sq6emm/eCzas-DCF-gps-stm32/doc/nucleo_architecture.pdf

# NUCLEO-H723ZG time receiver: e-CzasPL 225 kHz + DCF77 77.5 kHz + OCXO

Architecture of the current hardware and firmware - state of 29 September 2026, firmware commit e436259, repository sq6emm/eCzas-DCF-gps-stm32 (firmware/nucleo-h723, firmware/common). SQ6EMM / e-CzasPL receiver experiments.

## 1. Purpose and overview

A software-defined receiver for two long-wave time signals on one inexpensive development board. Two tuned ferrite rods feed two 16-bit ADCs that sample the band directly at 1 Msps; everything else is software: phase-locked mixers, coherent carrier trackers, the unchanged e-CzasPL firmware core for the time frames, an own DCF77 receiver with a per-minute time-code decoder, and a loop that steers a 10 MHz OCXO to the received carriers. The board runs continuously; a logger on the 'power' server records its text log and the two 2 kHz baseband streams for offline analysis.
| e-CzasPL | DCF77
transmitter | Solec Kujawski, 234 km, bearing 20° | Mainflingen, 580 km, bearing 261°
carrier / modulation | 225 kHz, phase modulation, 50 b/s, 3-s slots | 77.5 kHz, AM second marks + pseudo-random phase code
what the NUCLEO takes from it | time of day (clock), carrier frequency | carrier frequency (OCXO reference), second, minute time code
role | the receiver's clock (e-CzasPL core) | frequency reference for the OCXO; independent time check

## 2. Hardware

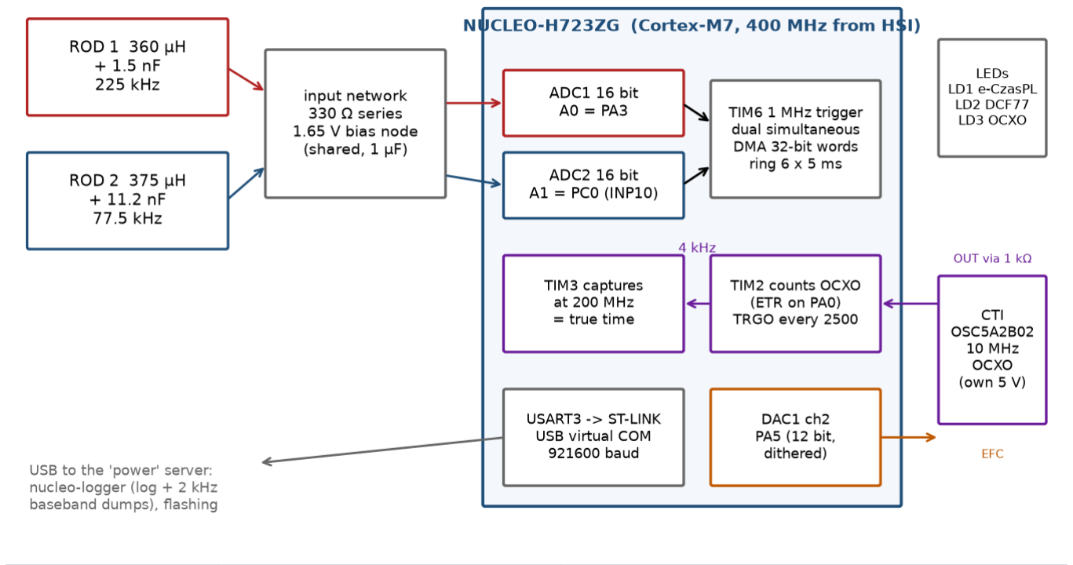
[picture p1: figure]

part | connection | notes
ROD 1 (225 kHz) | A0 = PA3 -> ADC1 | 360 µH ferrite rod, 1.5 nF tuning capacitor at the board, 330 Ω series
ROD 2 (77.5 kHz) | A1 = PC0 -> ADC2 (INP10) | 375 µH rod, 10 nF + 1.2 nF at the board, 330 Ω series
bias | shared 1.65 V node, 1 µF | both inputs biased to mid-scale (ADC mean ~32280 of 65535)
OCXO CTI OSC5A2B02 | OUT -> 1 kΩ -> PA0 (TIM2_ETR); EFC <-PA5 (DAC1 ch2); own 5 V | 10 MHz HCMOS; EFC slope measured +0.816 ppb per DAC code (1.07 ppm/V); locked near code 2252 = 1.815 V
MCU clock | HSI (16 MHz into the PLL) -> 400 MHz core, 200 MHz timers | the board has no crystal; HSI is ~+0.6 % off and wanders - the firmware measures it against the OCXO continuously
USB (ST-LINK) | USART3 virtual COM, 921600 baud | text log + binary baseband packets; also flashing (st-flash)

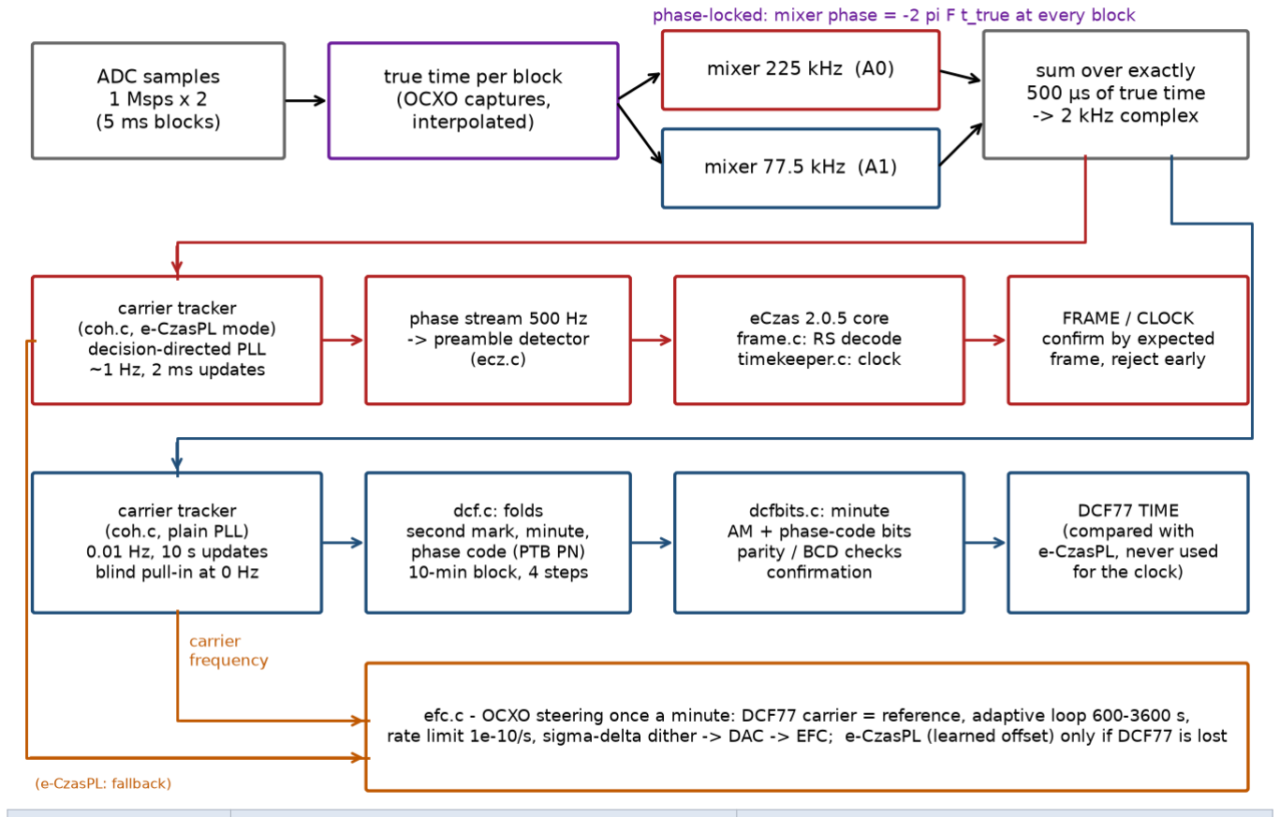
[picture p2: figure]

NUCLEO e-CzasPL + DCF77 receiver - architecture, 29.09.2026 - page 2

part | connection | notes
LEDs | LD1 green, LD2 yellow, LD3 red | LD1 e-CzasPL / LD2 DCF77: on = carrier locked, short blink = decode; LD3: on = OCXO locked, 1 Hz = calibrating/holdover

Input wiring: doc/nucleo_225_77kHz_input.pdf. OCXO wiring: doc/nucleo_ocxo_test_b.pdf.

## 3. Time base: sampling on true (OCXO) time

TIM6 triggers both ADCs together every 200 timer ticks (1 Msps, dual regular simultaneous mode); DMA writes 32-bit
words (ADC2 << 16 | ADC1) into a ring of 6 blocks of 5000 samples (30 ms). Because the CPU/timer clock (HSI) is
~6000 ppm off and wanders, sample count is not time. Therefore TIM2 counts the OCXO's 10 MHz on its external-clock input and produces a trigger every 2500 cycles (4 kHz); TIM3 timestamps each trigger in timer ticks. Interpolating between these captures gives the true time of every ADC sample. The previous build used the LSE watch crystal the same way (TIM16); -DOCXO_REF selects the OCXO.
Consequences: the mixers are phase-locked to true time (their phase is set to -2 pi F t_true at every 5 ms block), and the decimator sums exactly 500 µs of true time per output sample (fractional samples are split). So the HSI wander never appears as carrier phase noise, and every carrier measurement is a measurement against the OCXO.

## 4. Signal chain

stage | e-CzasPL | DCF77
mixer + decimation | 225 kHz, 2 kHz complex baseband | 77.5 kHz, 2 kHz complex baseband
carrier tracker (coh.c) | search: 2-s FFT; decision-directed 2nd-order PLL on the two data phase levels, ~1 Hz, updates every 2 ms | blind pull-in at 0 Hz (OCXO build; FFT search 128 s as fallback after 3 min); plain PLL 0.01 Hz, updates every 10 s; counts as locked only when its second marks are verified (spur rule: a line without marks is rejected after 60 min)
data | carrier-relative phase at 500 Hz -> ecz.c preamble detector -> eCzas 2.0.5 core (frame.c Reed-Solomon, CRC; timekeeper.c clock, sync, rejection of frames that disagree with the clock; confirmation of undecodable frames by the expected frame) | dcf.c: second mark (fold of the 100/200 ms reductions), minute marker (second 59), phase code (fold of the fixed-sign seconds correlated with the PTB sequence, anchored at pm_ref); dcfbits.c: per-minute AM + phase-code bits, parities, BCD ranges, confirmation by a second decode or by the expected frame
evaluation | per frame (every 3-s slot) | every 10 min (block, in four ~8 ms steps 0.1 s apart); early checks every 10 s until the first block: marks ~2 min, minute ~6 min, phase code ~7 min after boot

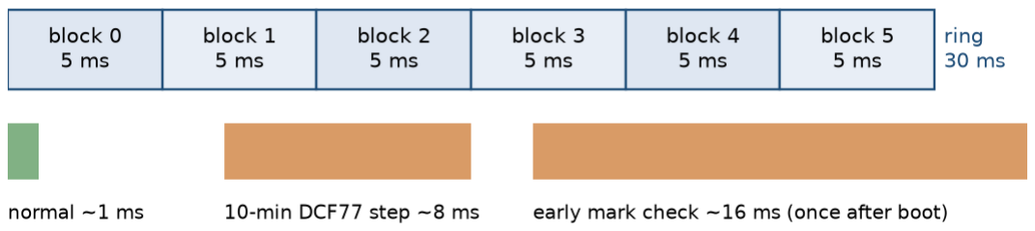
[picture p3: figure]

NUCLEO e-CzasPL + DCF77 receiver - architecture, 29.09.2026 - page 3

## 5. OCXO steering (efc.c)

Once a minute each carrier tracker reports its mean frequency against the OCXO time base (y = f / F; y > 0 means the OCXO runs slow). The steering loop turns that into a DAC code:
element | current setting
reference | DCF77 carrier (PTB-steered) only (EFC_WE_MAX 0); e-CzasPL steers only when DCF77 is lost, with its offset to DCF77 learned while DCF77 is clean (minute noise < 2 ppb)
start | straight into lock at code 2253 with the known slope 0.816 ppb/code; a station counts after 2 whole locked minutes
loop | 2nd-order PLL on the carrier phase (time error = integral of y), damping 0.7; time constant 600 s by day, lengthened automatically up to 3600 s when DCF77's minute noise grows (night)
actuator | DAC1 ch2 12 bit on PA5 -> EFC directly; changes rate-limited to 1e-10 / s (the 0.01 Hz DCF77 loop must not slip); first-order sigma-delta dither between neighbouring codes every 5 ms for sub-LSB resolution
calibration (fallback) | without a known slope: 3 min wait, half-way ramp, measured slope, sign checked; no response = FAILED
log line | OCXO once a minute: code and volts, state, source, e-CzasPL weight, offset (ppb), time error (ns), slope, loop time constant, learned e-CzasPL-DCF77 offset

Simulation (host/efcsim.c) before each change: by day ~18 ns time wander; a simulated night (3x DCF77 noise + ±300 ns sky-wave) 98 ns with the adaptive loop against 332 ns with a fixed 600 s loop; mixing both stations' frequencies was worse (585 ns) and is not used.

## 6. Processing budget

Processing per 5 ms block must on average stay far below 5 ms; a single slow block may take up to ~25 ms before the DMA overwrites unread samples (OVERRUN) - two heavy tasks in one sample took 32 ms on 28 Sep 21:38 and broke the DCF77 timing. Everything runs in the main loop, one 5 ms block at a time (no RTOS). Measured: CPU ~20 %, longest block 1-2 ms normally, 8-9 ms in the 10-min DCF77 steps. The early checks and the four block steps are placed in different samples so that two heavy tasks never meet. The host benches cannot see CPU time: the 'longest block' in the STATUS line is checked after every flash.

## 7. Outputs (text log on the USB serial port)

line | when | content
STATUS | 10 s | time (e-CzasPL clock), e-CzasPL carrier state and loop noise, frame counters, DCF77 carrier state, MCU clock offset, CPU %, longest block, ADC means/min/max, OVERRUN / PLBAD flags
FRAME / CLOCK | every e-CzasPL frame | correlation, SNR, RS corrections, decoded time; accepted / confirmed / REJECTED (early frames ~-2.4 s)
CARRIER | 1 min | both carriers: frequency vs OCXO (mHz), C/N0, loop noise, unwrapped phase, state
OCXO | 1 min | steering state (see section 5)
DCF77 TIME | 1 min | decoded DCF77 time, status (confirmed / by expected frame / unconfirmed / not decodable), comparison with e-CzasPL
DCF77 | 10 min | second mark, minute, phase-code timing with significance; DCF77 second vs e-CzasPL second, also at the transmitters
STATS | 1 h | guaranteed e-CzasPL frame at :03 (expected / heard / correct / confirmed), all time frames, early frames, DCF77 minutes, mean C/N0
TIMEMAP | 10 s | sample count -> e-CzasPL time (for offline alignment of the dumps)

NUCLEO e-CzasPL + DCF77 receiver - architecture, 29.09.2026 - page 4

line | when | content
binary packets | continuous | 2 kHz complex baseband of both mixers (A5 5C e-CzasPL, A5 5B DCF77), written to .c64 files by the logger

NUCLEO e-CzasPL + DCF77 receiver - architecture, 29.09.2026 - page 5

## 8. Host side (server 'power', all in Docker containers)

component | what it does
nucleo-logger | reads the USB serial port; text log /data/claude/nucleo-h723/log/rx.log, 10-min .c64 baseband files
nucleo-carrier-cmp | e-CzasPL vs DCF77 carrier comparison from the CARRIER lines (the board clock cancels): offset, Allan deviation, hourly report
nucleo-dcf-track | DCF77 timing from the dumps with e-CzasPL assistance (10-min phase-code lag, significance)
build / flash | arm-none-eabi-gcc in image eczas-arm:1, make CFLAGS_EXTRA='-DAUDIO_DUMP -DOCXO_REF'; st-flash over the ST-LINK
host tests | firmware/host: dcfsim, dcfminsim (the NUCLEO's DCF77 code on recordings; DCF_QUICK, DCF_BLIND, DCF_STAGED as the firmware), efcsim (steering loop vs a simulated OCXO); tools/dcfbench.py and dcfminbench.py: noise benches on KiwiSDR recordings with GPS truth - every DCF77 change must keep 0 wrong confirmed minutes
references | IC-7610 over LAN (e-CzasPL + DCF77, best reference receiver), KiwiSDR (Czech Republic, GPS-timed), Legnica bench (eCzas module)

## 9. Measured performance (28-29 Sep 2026)

| e-CzasPL | DCF77
C/N0 on the rods | 45 dB-Hz, day and night | 12-21 dB-Hz by day, 6-14 at night
carrier noise per minute (day) | 0.29 ppb | 0.71 ppb
decoding | 99.6 % of all time frames; 98.7 % of the guaranteed frame at :03 (00:30-09:30 UTC) | ~95 % of minutes confirmed by day; ~30 % in the worst night hours
second / timing | frames vs clock ±0.25 ms | phase code ±0.07 ms (30-min values)
e-CzasPL vs DCF77 carrier | -0.92e-9 over 9 h (Allan deviation 1.8e-10 at 3 h) | reference
OCXO locked to DCF77 | | 0.5-1 ppb rms per minute by day, time error ±0.25 µs by day, ±1 µs at night (fixed loop)
early e-CzasPL frames (-2.4 s) | detected and rejected, never used for the clock (events 31-50 all caught by the NUCLEO or the IC-7610)

## 10. Known limitations and next steps

- DCF77 on the small rod is weak at night (6-14 dB-Hz): minute decoding then relies on the expected frame; a better DCF77 antenna helps most.
- Absolute time: the e-CzasPL and DCF77 seconds differ by ~9 ms at the board; propagation (1.93 / 0.78 ms) is known, the rest (decoder and transmitter offsets) needs a GPS PPS reference (LEA-M8T) for a one-off calibration.
- The MCU runs on HSI and every sample is corrected in software; clocking the MCU from the OCXO (HSE bypass) would remove that layer.
- Third station TDF 162 kHz (Allouis): decoder proven offline on IC-7610 recordings; needs a 162 kHz rod (doc/three-station-design.md, doc/three_rods_layout.pdf) and a third mixer/tracker.
- Time output to other equipment (NMEA over USB to chrony, or NTP/PTP over the board's Ethernet) is not implemented yet.
