sq6emm/eCzas-DCF-gps-stm32/doc/antenna_head.pdf

~152

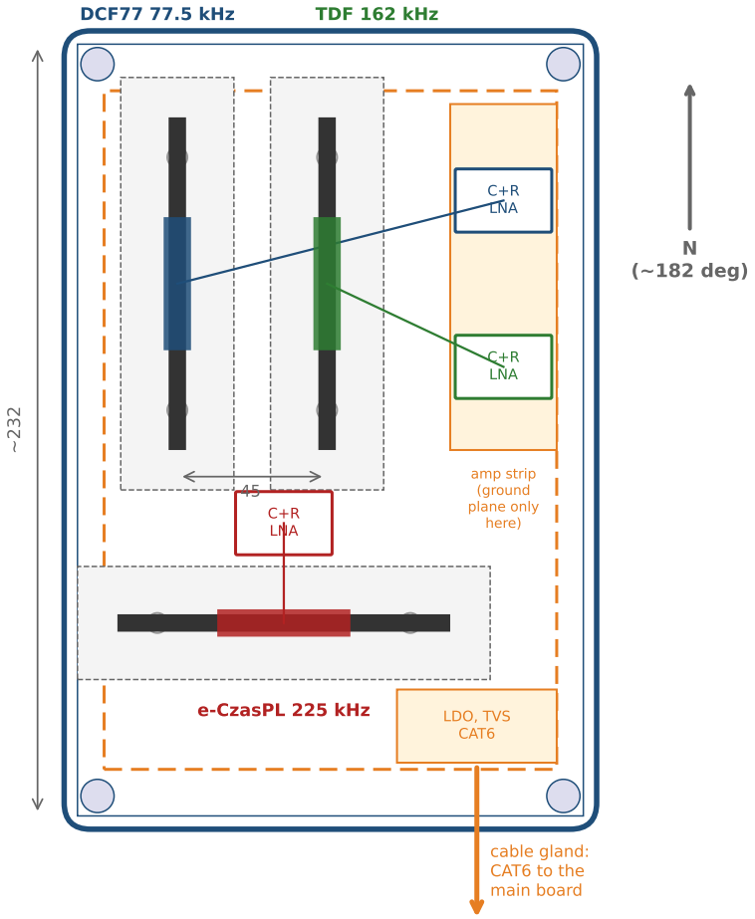
[picture p4: figure]
amp strip (ground plane only here); LDO, TVS CAT6; cable gland: CAT6 to the main board; C+R LNA; DCF77 77.5 kHz; TDF 162 kHz; e-CzasPL 225 kHz; N (~182 deg)

15-20

board

side view (rods DCF77 / TDF end-on), ~53 mm inside

N

E

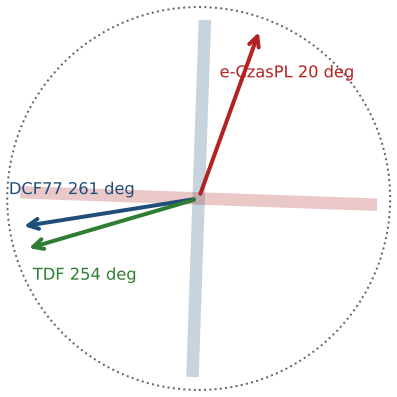
[picture p5: figure]
e-CzasPL 20 deg; DCF77 261 deg; TDF 254 deg

S

W

station bearings (arrows) and rod axes (bars)

# Antenna head - top view to scale (mm)

Hammond 1554VAL2GY (polycarbonate IP68, 240 x 160 x 60 mm outside, ~232 x 152 x 53 inside); rods 10 x 100 mm, L1 500 uH + 7-turn L2 (rod-antenna-spec.md); head board under the rods; GPS: separate antenna.

Rods at 90 deg: DCF77 + TDF parallel, e-CzasPL crosswise.

Box long side (DCF77 / TDF axis) to ~182 deg, i.e. ~north-south; each rod is then off its ideal (broadside) direction by

DCF77 11, TDF 18, e-CzasPL 18 deg: at most -0.45 dB.
Board under the rods, rods on plastic standoffs 15-20 mm above it;

no copper under the rods except narrow traces, ground plane only

in the amp strip and the supply corner, no closed copper loops.

Tank (L1 + C + R, Q ~ 30) at each rod; tune in place with all

three rods mounted and the lid on (SPECTRUM hump).
Rod spacing 45 mm (rods on different frequencies couple weakly):

verify with the prototype (resonance with / without neighbours).

GPS: a separate active antenna (sky view) on its own coax.

150 mm rods: the same layout in a 1554X2GY (300 x 200 x 90).

SQ6EMM / e-CzasPL receiver experiments, 30.09.2026 - a proposal, verify with the prototype (frontend-architecture.md, 6); box inside dimensions from a distributor listing - check the Hammond drawing

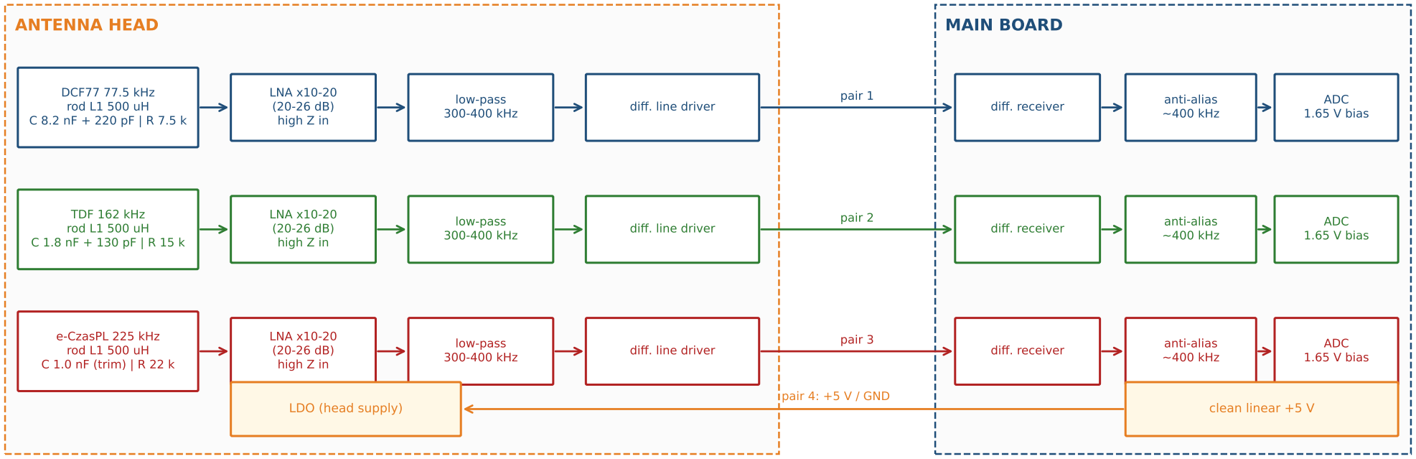
[picture p6: figure]
ANTENNA HEAD; MAIN BOARD; DCF77 77.5 kHz rod L1 500 uH C 8.2 nF + 220 pF | R 7.5 k; LNA x10-20 (20-26 dB) high Z in; low-pass; 300-400 kHz; diff. line driver; pair 1; diff. receiver; anti-alias; ~400 kHz; ADC 1.65 V bias; TDF 162 kHz rod L1 500 uH C 1.8 nF + 130 pF | R 15 k; pair 2; e-CzasPL 225 kHz rod L1 500 uH C 1.0 nF (trim) | R 22 k; pair 3; LDO (head supply); clean linear +5 V; pair 4: +5 V / GND

pair | variant A (three lines) | variant B (one summed line)
1 | DCF77 | three stations summed
2 | TDF | spare
3 | e-CzasPL | spare
4 | +5 V / GND | +5 V / GND

CAT5e / CAT6, differential twisted pairs

# Antenna head - signal chain per station, cable and main board

Values: C0G capacitors at the rod (C = 1/((2 pi f)^2 L), recompute

from each rod's measured L), R across L1 for Q ~ 30.

Why the amplifier: the rod's antenna noise must stay well above the

ADC noise floor (measured ~15 dB margin at the tank; the 7-turn

link alone would cost ~18 dB).

LNA: <= 10 nV/sqrt(Hz), GBW >= 50 MHz for x20 at 225 kHz (or 2 stages).

Variant B: one ADC input for all three stations (STM32H730),

separated by the firmware's digital mixers.

ESD/TVS at both cable ends; common-mode rejection by the pairs.

GPS: separate active antenna, own coax to the main board.

SQ6EMM / e-CzasPL receiver experiments, 30.09.2026 - see frontend-architecture.md
