sq6emm/eCzas-DCF-gps-stm32/doc/nucleo_225kHz_input.pdf

# Frame antenna to NUCLEO-H723ZG A0 - simplest input

For the e-CzasPL 225 kHz probe firmware (ADC on A0 = PA3, 1 Msps)

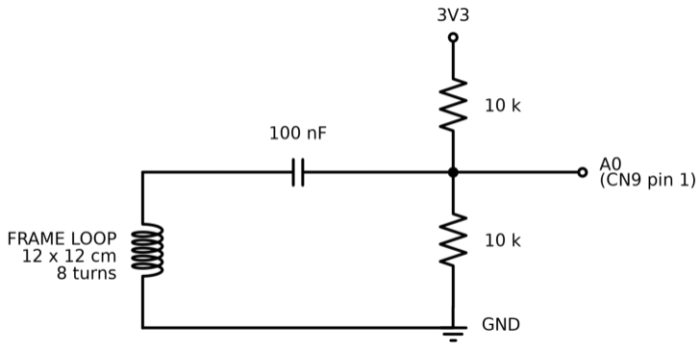
[picture p11: figure]

## Parts

1 x capacitor 100 nF (any ceramic)

2 x resistor 10 kOhm

## Connections

Loop end 1 -> 100 nF -> A0 (CN9 pin 1)

A0 -> 10 k -> 3V3 | and | A0 -> 10 k -> GND

Loop end 2 -> GND

3V3 and GND: the pins with these labels on CN8, next to CN9.

## Why

The two 10 k resistors hold A0 at 1.65 V, the middle of the ADC range.
The 100 nF passes the 225 kHz signal but keeps the loop (a short at DC) off that bias.

## What the probe should show

ADC mean about 32768 and no 'min 0'. A received carrier: SNR clearly above 0 dB and a steady offset of a few Hz. Turn the loop for the highest SNR.

Later, for about 30x more signal: add 27 nF (C0G) directly across the loop ends.

SQ6EMM / e-CzasPL receiver experiments, 27.09.2026
