sq6emm/eCzas-DCF-gps-stm32/doc/antenna_head.png

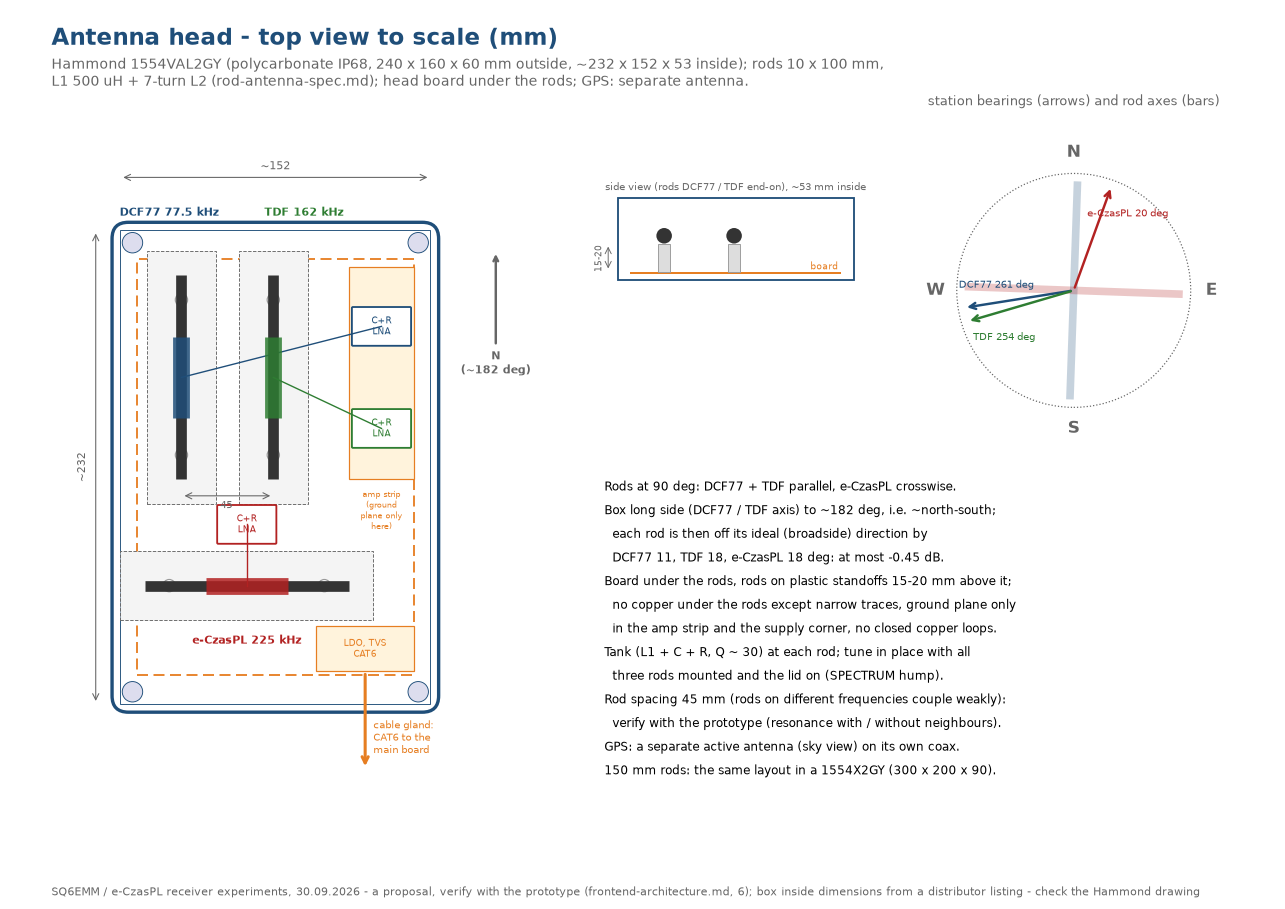
doc/antenna_head.png
