sq6emm/eCzas-DCF-gps-stm32/doc/nucleo_gps_pps.png

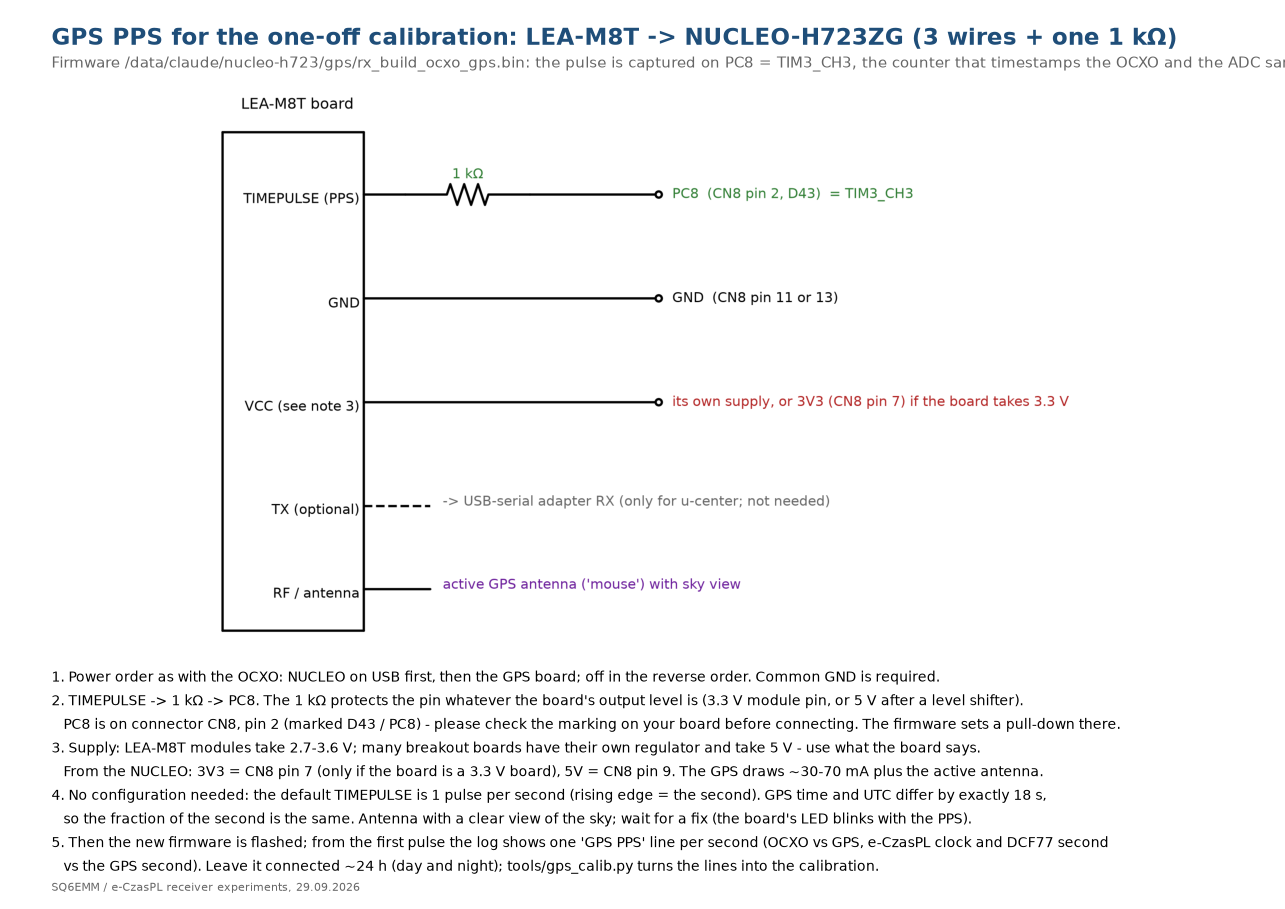
doc/nucleo_gps_pps.png
