sq6emm/eCzas-DCF-gps-stm32/doc/three_rods_layout.png

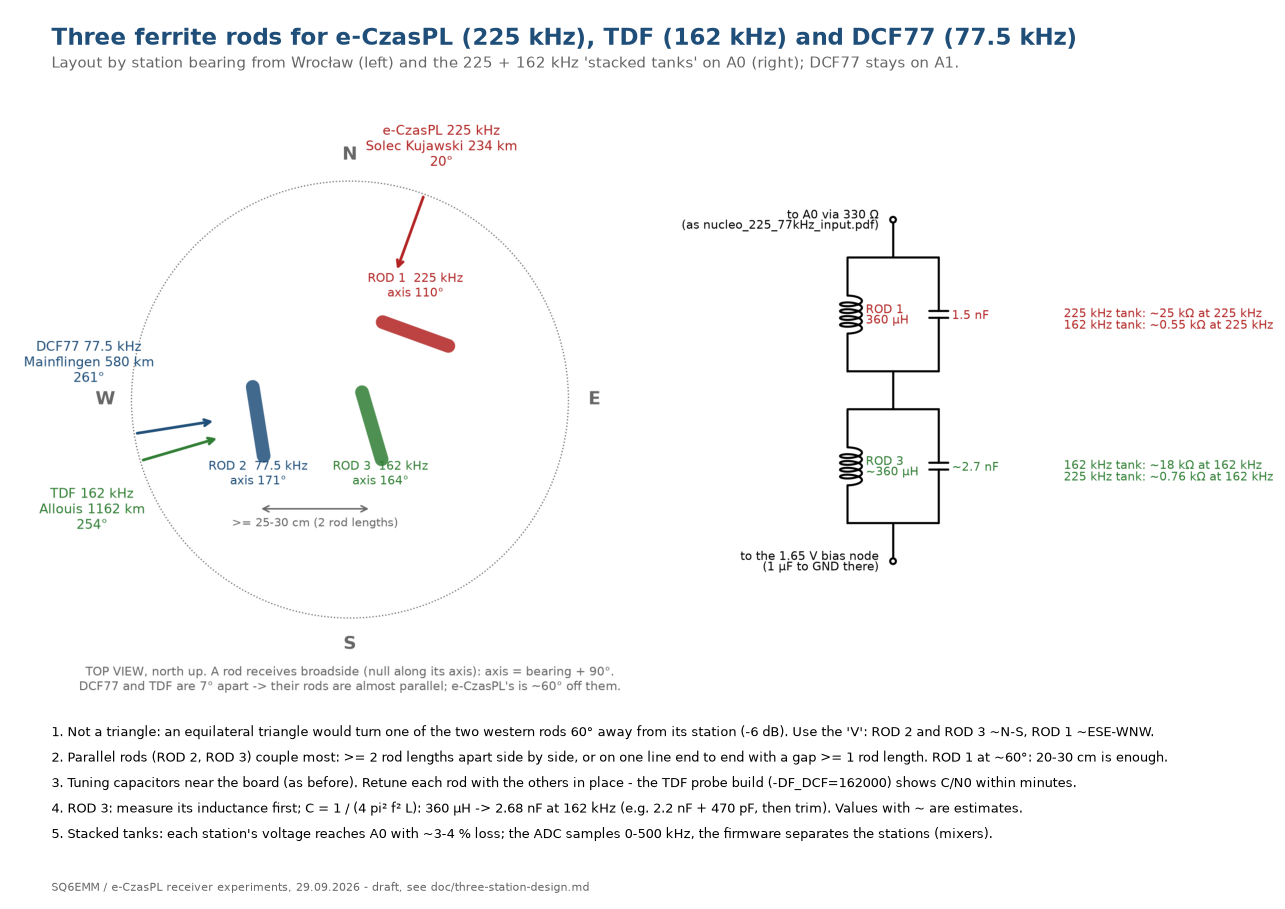
doc/three_rods_layout.png
