sq6emm/eCzas-DCF-gps-stm32/doc/nucleo_ocxo_test.png

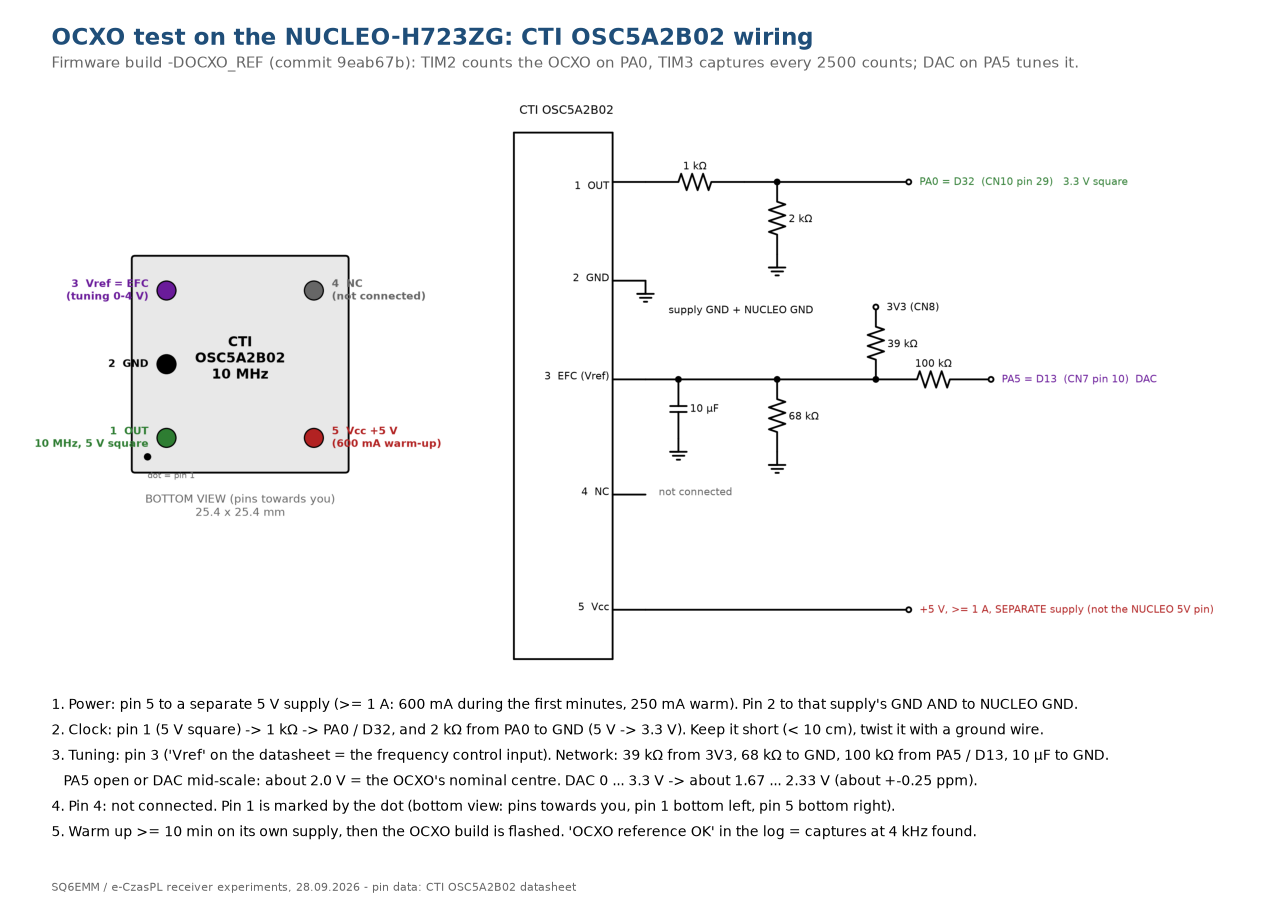
doc/nucleo_ocxo_test.png
