sq6emm/eCzas-DCF-gps-stm32/(commit log)

2026-09-27 NUCLEO-H723ZG port: direct-sampling receiver with the unchanged eCzas core
    ADC 1 Msps on A0, mixer phase-locked to the LSE crystal (HSI clock), 10 kHz
    stream into dsp.c/frame.c/timekeeper.c. Includes the serial/audio logger and
    comparison tools. First run decodes 85 % of time frames next to the IC-705.
2026-09-27 NUCLEO: complex +-400 Hz image filter before the real part (84.5 % -> 92.7 % of time frames)
2026-09-27 Move the STM32 work out of the eCzas repo: firmware/, tools/, doc/, PLAN.md
    History of Firmware/nucleo-h723 kept (subtree split). The eCzas core comes from the
    eczas submodule. Build is byte-identical to the running firmware.
2026-09-27 Coherent receiver core: carrier tracker (coh.c) + eCzas detector (ecz.c) + host test vs the old core
    Same tracker code for eCzas and DCF77 (independent instances). eCzas: 20-32 % more time frames
    than the SI4735-style core in weak signal, equal otherwise, 0 wrong times in all host tests.
2026-09-27 M3 firmware: coherent receivers for e-CzasPL and DCF77, independent of each other
    No more SI4735 imitation: phase-locked mixers -> 2 kHz complex -> own carrier tracker per
    station (coh.c) -> eCzas frames (ecz.c + frame.c/timekeeper.c) and DCF77 timing (dcf.c).
    CARRIER lines with C/N0, frequency and phase per station, DCF77 report every 10 min, LD2 =
    DCF77 lock. Both streams dumped as 2 kHz complex (logger: ecz_*/dcf_*.c64).
2026-09-27 M3: DCF77 counts as locked only with confirmed second marks (LD2, STATUS, CARRIER ppb)
    A local spur can be tracked but has no 1-s amplitude pattern; the ppb comparison printed
    +21000 ppb on the -1.73 Hz spur. After a spur rejection the old mark result is cleared.
2026-09-27 M3: fix sample skips every 10 min (DCF77 evaluation 60+ ms -> 16 ms), 60 ms DMA ring, line buffers
    The 10-min dcf_block used % in its inner loops and outran the 40 ms DMA ring: ~27 ms of
    samples were skipped each time, shifting all later frame timing (eCzas clock corrections,
    broken DCF77 tracker blocks). Now: doubled fold array without modulo (16 ms measured),
    ring 60 ms, STATUS shows the longest block; STATUS/put_line buffers no longer truncate.
    [main.c]
2026-09-28 DCF77: follow the drift of the DCF77 second through the LSE time scale (fold shifted by -f/77500)
    The LSE crystal runs ~1.5 ppm fast, so the DCF77 second walks ~5.6 ms/h through the LSE
    second; the running fold (~1 h) was not following it and the 'vs e-CzasPL' offset drifted
    -7 -> -22 ms in two hours. The shift uses only the DCF77 carrier's own frequency. Offline on
    tonight's data: -10.1..-10.7 ms steady over 2 h.
    [main.c]
2026-09-28 DCF77 spur check: count through re-searches that find the same line (+-0.15 Hz)
    After the 03:39 reflash the -1.8 Hz spur was lost and found again every ~20 min at slightly
    different frequencies; the 60-min count restarted each time and the spur was never rejected.
2026-09-28 DCF77 spur rule: never reject a line that has shown second marks
    At 07:18 on 28 Sep the real DCF77 carrier (-0.1 Hz) was rejected after four
    good mark blocks (7-10 sigma) and one weak one: the block count was never
    reset by a good mark. Now a line with a >=6 sigma mark is proven and kept;
    only lines without any mark in their first 60 min are rejected. Replay of
    the 05:01-07:21 baseband: old code rejects -0.121 Hz, new code keeps it; the
    -1.77 Hz spur is still rejected.
    [main.c]
2026-09-28 tools/icomlan: Icom LAN/WLAN client recording the 12 kHz IF output
    Receive-only client for the Icom network protocol (after kappanhang and
    wfview): login, CI-V and audio streams, retransmits, 10-min WAV files.
    IF -> 8 kHz USB-audio conversion (one-sided), a watcher feeding the eCzas
    reference pipeline, and the USB AF vs WLAN IF comparison.
    IC-705 over WLAN, 28 Sep 09:17-09:27 UTC: USB AF 15 frames decoded, WLAN
    IF 18; 0 of 60001 packets lost. Prepared for the IC-7610 (MAIN 225 kHz /
    SUB 77.5 kHz as a stereo stream).
2026-09-28 tools/kiwi: KiwiSDR GPS-timed references for e-CzasPL and DCF77
    kiwi_ref.py records 225 kHz (or 77.5 kHz) IQ from public KiwiSDRs, places
    the 512-sample blocks by their GPS timestamps into 10-min UTC slots and
    feeds the e-CzasPL reference pipeline (frames, early frames) or dcfsim
    (the NUCLEO's coh.c + dcf.c) with a GPS time base. cmp_site.py compares the
    carrier quality at a Kiwi with our own recording in the same seconds; on
    28 Sep it showed the disturbance from ~09:15 UTC is local to our site.
2026-09-28 DCF77 tuning bench on GPS-timed Kiwi data
    tools/dcfbench.py: clean KiwiSDR DCF77 (tools/kiwi, GPS time base) made as
    weak as the NUCLEO's reception (calibrated complex noise, crystal error
    -1.8 ppm with its carrier offset), run through dcfsim variants and scored
    per 10-min block against the truth from the clean signal: second mark,
    minute (must be second 59), phase-code time; wrong results counted.
    dcf.h / dcfsim.c: DCF_KEEP, DCF_MARK_MIN, DCF_MIN_MIN and the carrier
    tracker config can be overridden with -D (defaults unchanged, firmware
    identical). tools/Dockerfile.bench: gcc + numpy image.
2026-09-28 icomlan: keep the file time right when the radio drops audio
    Over WLAN the IC-705 sometimes drops audio without a gap in the packet
    sequence (28 Sep 11:10-11:30: 47444 instead of 48000 samples/s), so later
    frames looked up to 7 s early. The recorder now compares each packet's
    arrival time with the samples written (against the lowest delay of the
    last 30 s) and inserts silence when it falls behind by > 100 ms. SIGTERM
    (docker stop) now closes the current file.
2026-09-28 dcfbench: fix the sign of the simulated crystal's carrier offset
    A fast LSE (e < 0) stretches the time axis and puts DCF77 below 0 Hz
    (the NUCLEO sees -0.14 Hz). The bench had +0.14 Hz, so dcf.c's drift
    compensation doubled the drift instead of removing it (wrong marks even
    at +20 dB-Hz). Now +20 dB-Hz: marks 100 % right, 0 wrong.
2026-09-28 doc: two-rod input (225 kHz on A0, 77.5 kHz on A1) with one shared bias node
    Both tuned ferrite rods (360 uH) sit between their ADC pin and a common
    1.65 V bias node that is decoupled to ground (1 uF): no coupling
    capacitors, one divider for both channels, and the tuned circuits are no
    longer loaded by the 10k/10k divider (Q about 8 -> about 50, roughly 15 dB
    more signal). C1 = 1.2 nF + 180 pF (225.8 kHz), C2 = 10 nF + 1.8 nF
    (77.2 kHz). Placement: rods crossed (225 kHz axis E-W, DCF77 axis N-S).
2026-09-28 doc: two-rod input PDF layout (title and all notes fit on the page)
2026-09-28 doc: second rod measured 375 uH -> C2 = 10 nF + 1.2 nF (77.7 kHz)
2026-09-28 doc: two-rod input redrawn with the tuning capacitors at the board end
    The rods are alone at the antenna end; each twisted pair ends at the board
    where C1 / C2 sit across it at the pins, with R1, R2, C3. All parts that
    need trimming are in one place; the cable capacitance (~50 pF/m) adds to
    C1 / C2 (with 1 m: C1 = 1.2 nF + 150 pF).
2026-09-28 kiwi_ref dcf: start the hourly dcfsim window at the first recorded slot
    A zero-filled lead-in (window 06:00-12:00, data from 10:40) let the carrier
    tracker hold a phantom line for 6 blocks; the spur rule then rejected 0 Hz,
    where DCF77 is, and the run ended searching. From the first slot: mark
    3.5 ms 91 sigma, minute 95 sigma, phase code 96 sigma, DCF77 second
    +4.78 ms after UTC (GPS) at Luisenfelde.
2026-09-28 doc: two-rod input with pin protection (330 Ohm series, optional clamp diodes)
    C1 / C2 -> R3 / R4 330 Ohm -> A0 / A1 limits the current into the pins
    (STM32 max 5 mA); a BAT54S / BAV99 dual diode per pin to 3V3 and GND is
    drawn as optional, to add later. The tuning capacitors stay on the rod
    side, so the tuning does not change.
2026-09-28 icomlan: timing guard rewritten - the first one inserted 10,236 s of silence
    28 Sep 12:31-12:41 the guard filled a 1 GB file with 10,236 s of silence
    (866,616 samples/s): after each insertion it shifted all stored reference
    lags as well, so the deficit never went away. Now: per second the smallest
    arrival lag, reference = median of the last 30; a deficit > 0.1 s in two
    consecutive seconds is filled (max 1 s at a time) and the reference is left
    alone; > 5 s is taken as a restart (re-anchor, no silence); stale arrival
    times are purged (16-bit sequence wraps every ~11 min).
    Offline simulation, 30 min of 10 ms packets with jitter and a 2 s WLAN
    stall: radio drop of 0.5 s without a sequence gap -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
2026-09-28 NUCLEO: DCF77 from its own rod on A1 (ADC2), e-CzasPL stays on A0
    ADC1 (A0 = PA3) and ADC2 (A1 = PC0, INP10) in dual regular simultaneous
    mode on the same TIM6 trigger; the DMA fetches one 32-bit word per sample
    pair from the ADC12 common data register (ADC2 << 16 | ADC1). The DCF77
    mixer takes the A1 half (-DDCF_ON_A0 for the old behaviour); the e-CzasPL
    path sees exactly the same samples as before. The ring is now 6 blocks of
    32-bit words (30 ms, 120 KB as before). STATUS shows mean / min / max of
    both ADCs.
    On the board 28 Sep 13:26 (new input doc/nucleo_225_77kHz_input.pdf): the
    min/max readout found the shared bias node at ~0 V (pins at 13 mV, A1
    clipping); after the user's fix both me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
    [main.c]
2026-09-28 dcf.c: phase-code fold on its own anchor, used only above 8 sigma
    The phase-code fold was indexed from the second mark, which is quantised
    to 0.5 ms and steps with the drift correction: each step realigned the
    fold and smeared it by 0.5-1 ms (timing jumping +4.8 / +5.7 / +4.9 ms from
    block to block). Now the fold has its own anchor (pm_ref), set from the
    mark when the minute is found and then moved only by the drift correction;
    the lag is still reported relative to the mark. Phase-code times are used
    (dcfsim, NUCLEO DCF77 vs e-CzasPL) only above DCF_PM_MIN = 8 sigma: the
    remaining 0.6-0.8 ms errors all had 5.4-6.5 sigma.
    Bench (tools/dcfbench.py, Kiwi Luisenfelde 10:40-13:40, GPS truth, 3 n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
    [main.c]
2026-09-28 DCF77 time code decoded every minute (dcfbits.c), next to the timing (dcf.c)
    Every second: AM (110-190 ms reduced or not) and PM (512 known chips from
    200 ms, inverted for 1; seconds 15-58, about 4x the energy of AM) are
    turned into log-likelihood ratios from the measured sample noise and
    added. The PM polarity and amplitude come from the known PM seconds 0-9
    (inverted) and 10-14 (not inverted). A minute is checked (bit 0 = 0,
    bit 20 = 1, P1 P2 P3, one of CEST/CET, BCD ranges); a failing parity group
    may flip its least reliable bit once. First confirmation: two standalone
    decodes that agree with the minutes elapsed. After that each minute is
    confirmed if it decodes to the expected time, or i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
    [main.c]
2026-09-28 Board design draft v0.1 and the e-CzasPL vs DCF77 carrier comparison logger
    doc/board-design.md: one board with the two rod inputs (direct sampling
    as on the NUCLEO), a u-blox timing GPS as the truth reference (PPS on a
    timer capture) and a 10 MHz OCXO that clocks everything and is steered
    through a 16-bit EFC DAC; outputs 10 MHz x2, 1PPS, USB, Ethernet. Open
    questions for the user listed.
    tools/carrier_cmp.py (container nucleo-carrier-cmp): from the NUCLEO's
    CARRIER lines, delta = phase_e/225000 - phase_d/77500 (the board clock
    cancels), segments at unlocks / restarts / slips, hourly report with the
    relative frequency offset and the Allan deviation, day / night.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
2026-09-28 board design v0.2: OCXO = CTI OSC5A2B02 (5 V, many units) - specs and consequences
    HCMOS 5 V output -> 74LVC1G17 to the 3.3 V HSE input and separate buffers
    for the 10 MHz outputs; own low-noise 5 V for 0.6 A warm-up; EFC 0-4 V at
    ~0.75 ppm/V: 16-bit DAC + REF5040 through a divider to ~1-3 V (~2.3e-11
    per LSB, dithered) or an 18-bit DAC. Enough for a loop at 1000-10000 s.
2026-09-28 board design v0.3: decisions - LEA-M8T, Ethernet, 12 V in, KiCad, JLCPCB assembly
2026-09-28 board design v0.4: GPS not on the board, header only (calibration station)
2026-09-28 NUCLEO: optional OCXO time base (-DOCXO_REF) instead of the LSE crystal
    The external 10 MHz OCXO (CTI OSC5A2B02, 5 V HCMOS through a 1k/2k divider
    to PA0 = D32) is counted by TIM2 (ETR, external clock mode 2); every 2500
    counts (4 kHz) TIM2's TRGO is captured by TIM3 (IC1 on TRC), which runs on
    the same timer clock as the ADC trigger TIM6 - the same mechanism as TIM16
    capturing LSE/8, so the phase-locked mixers and all timing follow the OCXO.
    The internal trigger (ITR1 expected) is verified at start: the one giving
    4 kHz captures is kept, otherwise 'OCXO reference NOT running'. EFC: DAC1
    channel 2 on PA5 (D13) at mid-scale (EFC_INIT) through 39k/68k/100k to the
    OCXO's control pin (~1.67-2.33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
2026-09-28 doc: OCXO test wiring (CTI OSC5A2B02 bottom-view pinout + NUCLEO connections)
2026-09-28 doc: OCXO test variant B - 4 wires + one 1 kOhm (EFC straight to the DAC on PA5)
2026-09-28 NUCLEO OCXO: close the loop - EFC steered from DCF77 (e-CzasPL fallback)
    common/efc.c: waits for 3 minutes on one source, calibrates the EFC slope with a
    half-way step (sign and size measured, dead EFC detected), then a second-order PLL
    on the carrier phase (tau 600 s, damping 0.7). EFC changes are rate-limited to
    1e-10/s so the ~0.01 Hz DCF77 carrier loop never slips, and dithered (first-order
    sigma-delta per 5 ms block) for sub-LSB resolution. Holdover when no carrier is locked.
    One OCXO line per minute. host/efcsim.c tests it against a simulated OCXO
    (slope 0.3..1.5 and reversed, offsets -300..+162 ppb, dropouts, dead EFC).
    STATUS names the reference (LSE/OCXO).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
    [main.c]
2026-09-28 NUCLEO LEDs: LD1 e-CzasPL / LD2 DCF77 on while locked, blink at each decode; LD3 OCXO loop state
    LD1/LD2 are inverted for 300 ms at every correctly decoded frame / DCF77 minute; LD3 is on when
    the OCXO loop is locked, blinks at 1 Hz while calibrating / moving / in holdover, off otherwise.
    Documented in the README (with the new per-minute OCXO line). EFC_INIT 2310 for this OCXO
    (162 ppb slow at 2048), so a restart does not start from mid-scale.
    [main.c]
2026-09-28 icomlan: IC-7610 over Ethernet - mirrored IF (--invert), stereo MAIN/SUB, DCF77 SUB analysis, K9AY scan
    The IC-7610 LAN IF is mirrored (RF f -> 12 kHz - (f - dial)); dials MAIN 226.000 / SUB 78.500 kHz put
    e-CzasPL and DCF77 at 13000 Hz. ifconv/if2af_watch/if2audio: --invert, --ch. dcf7610.py runs the
    NUCLEO's dcfsim/dcfminsim over the SUB channel hourly. K9AY and preamp/ATT scan results in the README.
2026-09-28 NUCLEO OCXO: steer from both carriers - DCF77 for accuracy, e-CzasPL (offset removed) for low noise
    efc_minute2(): e-CzasPL's offset against DCF77 is learned while both are locked (10 min, then
    3 h average) and removed; the two are weighted by their measured minute-to-minute noise (inverse
    variance); > 10 ppb disagreement = DCF77 alone that minute; one lost = the other alone. The OCXO
    line reports the weight and the learned e-CzasPL-DCF77 offset (a continuous carrier comparison).
    Known slope (0.816 ppb/code, EFC_SLOPE) starts straight in LOCK at EFC_INIT 2253 - no calibration.
    efcsim (EFC2, NIGHT, KNOWN, dropout 3): offset learned to 0.01 ppb, no frequency bias, DCF77
    dropouts 94 ns time wan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
    [main.c]
2026-09-28 DCF77: faster lock - early second-mark check and blind pull-in at 0 Hz on the OCXO build
    dcf_quick_mark(): until the first marks, the current block's fold is checked every 10 s once
    >= 60 s are tracked (10 sigma), instead of waiting for the first 10-min block. The mark search
    moved into mark_find() (shared with dcf_block; output byte-identical to before on all 11 bench
    inputs with the new options off). coh_pull_at()/coh_search(): the OCXO build pulls DCF77 in at
    0 Hz right away (the OCXO is steered to the carriers), normal search if no marks within 3 min.
    Host sims: DCF_QUICK=1, DCF_BLIND=hz.
    Bench (Kiwi Luisenfelde, 13/15/17 dB-Hz x 3 seeds): marks at 120 s (blind) / 240 s instead of
    600 s;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
2026-09-28 DCF77: minute marker and phase code also checked early - first confirmed minute ~12-15 min after boot
    minute_eval()/pm_eval() split out of dcf_block (output byte-identical with the options off);
    dcf_quick_minute() (8 sigma, while no minute) and dcf_quick_pm() (until the first 10-min block)
    evaluate the running sums every 10 s without decaying them. Host sims: DCF_QUICK=2, DCF_QMIN.
    Minute bench (13/15/17 dB-Hz x 3 seeds, blind pull-in): first confirmed minute 41/34/33 min
    (original) -> 27/15/12 min, confirmed minutes 66/77/79 % -> 73/86/89 %, WRONG confirmed 0;
    early minute always the right one (8 and 6 sigma tested; 8 kept). Timing bench: 0 wrong,
    phase code 94-100 % of blocks, rms 168-176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
    [main.c]
2026-09-28 e-CzasPL reference processor: no frame lost at the 10-min file joins
    Each file gets the last 30 s of the previous file in front when the two join exactly (within
    50 ms); frames and slots are counted by the file in which the slot ends, so nothing is doubled.
    Replay of the IC-7610 20:00-21:30 files, old vs new: every join now yields its 1-2 missing slots,
    time frames decoded 308 -> 310 (20 h) and 158 -> 160 (21 h), no slot lost or doubled. Shared by
    eczas-ic7610-proc, kiwi-ref-proc and eczas-ic705-proc (restarted 21:4x UTC).
2026-09-28 NUCLEO: early DCF77 checks in their own samples - they caused an OVERRUN
    21:38:43: the 10-min DCF77 block (~24 ms) and the early phase-code check (~8 ms) ran in the same
    sample: 32 ms against a 30 ms sample ring -> OVERRUN, samples skipped, the DCF77 second moved
    against the phase-code anchor and every minute failed afterwards (AM=PM ~50 %). The early mark /
    minute / phase-code checks now run at 0 / 3 / 6.5 s of each 10 s and never in a block's sample.
    Host sims use the same samples; minute bench unchanged (12.0 / 14.3 / 25.3 min, WRONG confirmed 0).
    The benches cannot see CPU time: the board's longest block is the check for this.
    [main.c]
2026-09-28 TDF (ALS162, 162 kHz) offline decoder on IC-7610 recordings
    Third LF station: 48 dB-Hz on the K9AY. Phase modulation +-0.8 rad, bit 0 = one ~100 ms cycle,
    bit 1 = two, DCF77 time-code layout (next minute, French legal time). tdf_decode3: complex LS
    fit per second with learned shapes (no phase unwrapping), matched-filter second alignment,
    minute marker folded over all minutes, parity repair, BCD checks, neighbour confirmation.
    Noise bench: confirmed 9/8/8/4/0 of 9 minutes at 49/25/22/20/18 dB-Hz, WRONG confirmed 0.
2026-09-29 NUCLEO: F_DCF overridable (TDF probe); TDF decoder: impossible dates count as failed
    Probe 29 Sep 2026 23:55-00:08 UTC (second mixer at 162 kHz, OCXO build): TDF on A0 (225 kHz rod)
    7-11 dB-Hz, on A1 (DCF77 rod) not detectable - the tuned rods reject 162 kHz; TDF needs its own
    162 kHz tuned rod (IC-7610 + K9AY: 48 dB-Hz).
    [main.c]
2026-09-29 doc: three-station design (e-CzasPL + DCF77 + TDF + GPS + OCXO) and three-rod layout
    Station bearings from Wroclaw decide the rods: DCF77 (261 deg) and TDF (254 deg) are 7 deg apart,
    so their rods are nearly parallel and e-CzasPL's (20 deg) ~60 deg off - a V, not a triangle (an
    equilateral triangle costs -6 dB on one western rod). Coupling rules, tuning capacitors, 225+162 kHz
    stacked tanks on A0, the value of three independent stations, GPS as calibration, OCXO as MCU clock.
2026-09-29 NUCLEO: 10-min DCF77 block in four ~8 ms steps; OCXO: DCF77 reference with adaptive loop
    1. dcf_block_step(): the block's work (fold update + half the coarse mark search / the other half
    + fine search + mark / minute / phase code) in four samples 0.1 s apart instead of ~24 ms in
    one (the sample ring holds 30 ms). mark_find split into mark_coarse/mark_finish with separate
    buffers for the early check and the block. One-shot dcf_block() kept for the host tools:
    byte-identical output to before on all 11 bench inputs. Staged (DCF_STAGED=1, as the firmware):
    minute bench 0 wrong confirmed, 13 dB-Hz first confirmed minute 25.3 -> 22.3 min; timing bench
    0 wrong, phase code 94-98 %,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
    [main.c]
2026-09-29 NUCLEO: hourly STATS line; DCF77 line gives the seconds at the transmitters
    STATS (every UTC hour): the guaranteed e-CzasPL time frame of each minute (second 03 = slot 1,
    measured; the frame description says slot 0): expected / heard / correct / confirmed; all time
    frames correct / confirmed / heard / early (-2.3..-2.7 s); DCF77 minutes confirmed / by expected
    frame / unconfirmed / not decodable; mean C/N0 of both. Slots attributed with the NUCLEO clock
    (tk_expected_n3). DCF77 10-min line: 'vs e-CzasPL second' also at the transmitters (ground-wave
    delays 1.93 ms Mainflingen / 0.78 ms Solec Kujawski removed); 'of the OCXO second' label.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
    [main.c]
2026-09-29 doc: NUCLEO receiver architecture (hardware, time base, signal chain, decoders, OCXO steering, budget, outputs, host side, measured performance)
    Generated by doc/nucleo_architecture.py (reportlab + matplotlib in a container); state of
    firmware e436259, measurements of 28-29 Sep 2026.
2026-09-29 carrier_cmp: accept '+' in the phases (positive phases were skipped: no rows 29 Sep 11:00-13:45)
    The CARRIER lines print the unwrapped phases with an explicit sign; after the 10:40 reboot the
    e-CzasPL phase was positive and the pattern ([-\d.]+) rejected every line. Missing rows backfilled
    from rx.log (164), old cmp.csv kept as cmp.csv.bak-20260929.
2026-09-29 GPS PPS calibration: capture on PC8 (TIM3_CH3), wiring sheet, analysis script
    Firmware (OCXO build): the LEA-M8T TIMEPULSE on PC8 = TIM3_CH3 is timestamped by the counter that
    also timestamps the OCXO and the ADC samples (5 ns steps), converted to true time within one 5 ms
    block (the capture ring holds ~128 ms), and reported once per second: 'GPS PPS #n | OCXO x ppb (1 s)
    | e-CzasPL clock y ms | DCF77 second z ms (phase code|second mark)'. Pull-down on PC8: nothing
    connected = no lines, no other change. Built as /data/claude/nucleo-h723/gps/rx_build_ocxo_gps.bin,
    NOT flashed yet (the user connects the GPS first).
    doc/nucleo_gps_pps.pdf: 3 wires + 1 kOhm (TIMEPULSE -> PC8 CN8 pin 2, GND, supp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
2026-09-29 TDF decoder in C (common/tdf.c) with host simulator and noise bench
    Streaming port of tools/tdf/tdf_decode3.py for the NUCLEO (input: the carrier tracker's derotated
    2 kHz samples, as dcf.c): learned shapes (tdf_shape.h), second start by a folded matched filter,
    per-second complex fit (bit 0 / bit 1 / none), minute marker folded over minutes, parity repair,
    BCD / range / date checks, confirmation by the next minute and by the expected frame (score >= 30,
    lead >= 15 over +-1/+-2 min). An unconfirmed decode without repairs can become the first reference
    only if the next minute agrees on >= 0.8 of the confident bits: the looser test let wrong hours
    through (3-32 wrong at 20-22 dB-Hz). host/tdfs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
2026-09-29 DCF77: a reference minute counts only while the minute ends stay on its grid
    With the minute marker moved (30-40 s off after an input gap on the IC-7610
    recording, 29 Sep 17:40 UTC), the elapsed minutes were rounded one off and each
    accepted expected frame carried the error on: 9-13 wrong minutes 'confirmed by
    the expected frame' in the 6-h runs. Now the reference is dropped when a minute
    ends more than 0.5 s (+20 ppm of the time since) off its grid, and a new one
    needs two agreeing standalone decodes again.
    IC-7610 windows: wrong 9/9/13 -> 0/0/0; Kiwi bench run1/run4: unchanged.
2026-09-29 OCXO: e-CzasPL steers for 15 min when DCF77 is grossly wrong (> 20 ppb, further from 0)
    29 Sep 20:10-20:40 UTC DCF77 on the NUCLEO rod fell to 2..-14 dB-Hz but stayed
    'locked'; minutes of +30..+50 ppb went into the loop because a disagreement
    with e-CzasPL always chose DCF77: EFC 2252 -> 2274.6, OCXO -17 ppb, 7 us.
    Now, in LOCK, a disagreement where DCF77 is > 20 ppb off and further from
    what the loop expects than e-CzasPL hands steering to e-CzasPL (learned
    offset removed) for 15 minutes; smaller disagreements stay with DCF77.
    New closed-loop replay of logged minutes (host/efcreplay.c,
    tools/efc_replay_extract.py; reproduces the logged EFC to 0.3 codes):
    29 Sep 20:00-20:47 time rms 6073 ->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
2026-09-30 OCXO: DCF77 steers only in minutes with C/N0 >= 0 dB-Hz
    The rod's DCF77 stayed 'locked' and verified at -14..0 dB-Hz on the nights of
    29/30 Sep. Minutes of DCF77 vs e-CzasPL since 28 Sep 18:00, by DCF77 C/N0:
    < -6 dB-Hz rms 20 ppb (12 of 26 > 10 ppb), -6..-2: 8 ppb, -2..0: 6 ppb;
    0..3: 4.5-5 ppb, 3..4: 3.4 ppb, unbiased (mean -0.8 as e-CzasPL's offset).
    Below 0 dB-Hz a minute no longer counts as DCF77 lock (and DCF77 again needs
    2 whole good minutes); from 0 dB-Hz up the noise is left to the adaptive loop
    (a higher gate would hand steering to e-CzasPL with its learned offset, which
    is worse while that offset is off, e.g. right after a reboot).
    Would have acted 1-27 min per hour in 7 night ho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
    [main.c]
2026-09-30 NUCLEO: spectrum diagnostic of both rods (SPECTRUM lines every 10 min)
    60 s after boot and then every 10 min: 256 Hann-windowed 4096-point FFTs of A0 and A1 at
    once (A0 real, A1 imaginary part of one complex FFT), every 4th block (~1 ms each, ~5 s).
    Per input the noise floor as the median PSD per band (A0 150-300 kHz / 3 kHz, A1
    40-120 kHz / 2 kHz; dB re 1 LSB^2/Hz), so the carriers of other stations do not lift it
    and the tuned rod's resonance shows as a hump, plus the 8 strongest carriers (15 dB over
    the local median). Purpose: is the DCF77 rod (weaker since 29 Sep, night dropouts with
    the carrier, not the noise, missing) still tuned to 77.5 kHz?
    Buffers (64 KB) in a new NOLOAD .dtcm secti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
    [main.c]
2026-09-30 NUCLEO: SPECTRUM lines without %f (newlib-nano printf has none: header and carrier kHz were empty)
2026-09-30 tools: second timing TDF / DCF77 / e-CzasPL on the IC-7610 (one sample clock), results in tools/tdf/README.md
    e-CzasPL - DCF77 +16.61 ms (day), e-CzasPL - TDF +16.48 ms (night, spread 0.13 ms), radio MAIN-SUB
    delay 0.00 +- 0.05 ms (same-frequency test): TDF and DCF77 within ~0.1 ms at the receiver. The
    NUCLEO's +8.9 ms (e-CzasPL - DCF77) is 7.7 ms less: an uncompensated delay in one of its chains.
2026-09-30 tools: NUCLEO timing check - firmware seconds vs model fits on its own 2 kHz mixer dumps
    30 Sep 14:00 block: DCF77 firmware (mark + phase code) 82.80 ms vs raw 82.55 (+0.25 ms);
    e-CzasPL core (TIMEMAP) 91.70 ms vs raw frame fit 99.01 (-7.31 ms). Raw e-CzasPL - DCF77
    +16.46 ms = the IC-7610's +16.6. Cause: the frame template / timing refinement use the core's
    RAMP_BLOCKS 8 (16-ms phase slew of the SI4735 + audio PLL chain); the NUCLEO's coherent tracker
    switches in ~5 ms (10-90 %, 2908 transitions averaged), so the template aligns ~7 ms early.
2026-09-30 host/cohsim: -c input = the NUCLEO's own 2 kHz e-CzasPL dump (ecz_*.c64), fed to the tracker as in the firmware
    30 Sep 14:00 dump: the core's frame times sit -7.53 ms from the raw frame starts (firmware on the board
    -7.31 ms): RAMP_BLOCKS 8 / 4 / 3 / 2 -> -7.53 / -3.72 / -2.68 / -1.65 ms, timekeeper jitter 212 / 322 /
    385 / 457 us, time frames 50 / 50 / 50 / 48 of 50. Keep 8 (lowest jitter) and correct the constant.
2026-09-30 NUCLEO: e-CzasPL frame times +7.4 ms (template lag of the 16-ms ramp model on the fast coherent tracker)
    The core's template / timing refinement assume the SI4735 chain's 16-ms phase slew (RAMP_BLOCKS 8);
    here transitions take ~5 ms, so frames were timed 7.3-7.7 ms early (board -7.31 ms; cohsim -c on
    the NUCLEO's own dumps -7.53 / -7.60 / -7.75 ms). ECZ_TEMPLATE_LAG_US (ecz.h) added to every frame time;
    RAMP_BLOCKS kept (shorter ramps: less bias but more jitter). cohsim -c, 3 blocks (29 Sep 12:00,
    30 Sep 02:00, 14:00): decoding identical (time frames 40 / 46 / 50, 0 wrong, same jitter), core
    time - raw frame start -0.12 / -0.35 / -0.18 ms. Expected on the board: DCF77 vs e-CzasPL second
    +16.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
    [main.c]
2026-09-30 doc: ferrite rod antenna spec - one type for e-CzasPL / TDF / DCF77, manufacturer RFQ text (EN + CN)
    10 x 150 mm rod (NiZn mu_i 400-1000 or MnZn 2000-2500; not 5K/10K MnZn, not shortwave NiZn),
    L1 = 500 uH +-10 % litz, unloaded Q >= 60, 7-turn link winding L2 on top. Our part: C0G capacitors
    at the rod (8.43 / 1.93 / 1.00 nF), R for Q ~ 30, acceptance checks with the SPECTRUM diagnostic,
    mounting (DCF77 + TDF rods parallel, e-CzasPL rod ~90 deg).
2026-09-30 doc: front end - antenna head (rods + amplifiers), CAT6 to the main board, one-line option, GPS in the head
    Head: rod tanks at the rods, one low-noise amplifier (20-26 dB) per rod, band limit, differential line
    driver, LDO; CAT6 twisted pairs (3 stations + power, or one summed line + GPS PPS/UART + power); main
    board: receivers, anti-alias low-pass, ADC. GPS antenna in the head >= 15 cm from the rods (magnet and
    ground plate of mouse antennas). Prototype test plan with the SPECTRUM diagnostic.
    rod-antenna-spec.md: corrected - a cable on L1 detunes the tank wherever C sits; the cable hangs on the
    amplifier (or L2, which costs ~18 dB); rod length 100-150 mm acceptable.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
2026-09-30 doc: antenna head drawing - top view to scale (rods, amplifier modules, head board, GPS antenna) + signal chain
    Page 1: 10 x 150 mm rods broadside to their stations (DCF77 / TDF parallel, e-CzasPL ~60 deg), copper-free
    zones, head board in the DCF77 / TDF rod-axis null, GPS antenna >= 150 mm from every rod, compass.
    Page 2: per station tank -> LNA -> low-pass -> line driver -> CAT6 pair -> receiver -> anti-alias -> ADC;
    power pair; variant A / B pair table.
2026-09-30 doc: antenna head in a Hammond 1554VAL2GY - 100 mm rods at 90 deg, board under the rods, GPS separate
    Drawing redone to scale for the box (~232 x 152 x 53 inside): DCF77 + TDF rods parallel 45 mm apart,
    e-CzasPL crosswise; box long side ~182 deg gives at most 18 deg off broadside (-0.45 dB). Head board under
    the rods, rods on 15-20 mm standoffs, ground plane only in the amp strip / supply corner. GPS: separate
    active antenna on its own coax. Rod RFQ: length 100 mm (EN + CN), winding 30-45 mm. 150 mm rods: 1554X2GY.
2026-10-01 OCXO: loop also slows on the 10-min noise of e-CzasPL - DCF77 (night sky-wave wander); replay tools
    The adaptive loop (tau = 600 s x sqrt(noise / ref), up to 6x) used only DCF77's minute-to-minute noise,
    measured on the steered offset: on 30 Sep/1 Oct it stayed at or below the 1.3 ppb reference all night and
    the loop stayed at 600 s while DCF77 wandered ~6 ppb over 20 min (01 UTC, time error -1.4 us).
    New: 10-min Allan variance of e-CzasPL - DCF77 (independent of the OCXO steering; e-CzasPL is quiet at
    45 dB-Hz), ~1 h average, reference (0.25 ppb)^2 = the daytime value (0.09-0.29 ppb). EFC_V10REF 0 = off.
    Offline replay (host/efcreplay, CN0_MIN 0, truth = e-CzasPL - learned offset; time err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
2026-10-01 TDF README: transmitter offsets corrected (+17.8 ms vs DCF77, +19.6 vs TDF); why ~17 ms - ramp shape, drift, not UT1
    The first version subtracted the path difference: a farther station sent earlier, so e-CzasPL's second
    leaves ~17.8 ms after DCF77's (not 15.5) and ~19.6 ms after TDF's (not 13.4); the NUCLEO prints -17.4.
    tools/eczas_transition_shape.py: e-CzasPL bit changes are ~18 ms linear phase ramps; the NRZ fit marks
    their middle; the preamble leaves idle 9.3 ms before the fitted start (ramp-start convention: ~8.5 ms
    late at the transmitter). Drift ~0.1 ms/day later (NUCLEO tracker -0.117 +- 0.010 ms/day over 2.35 d;
    IC-7610 +16.50 -> +16.61 ms in 1.1 d): not UT1 (UT1-UTC moves ~1.1 ms/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
2026-10-01 NUCLEO: GPS PPS anchor of the 2 kHz scale one block (5 ms) late - fixed
    pl_t0 was the true time of the block END (rd already advanced) but pl_n0 = n2k counts the outputs
    before the block (its START), so every GPS PPS landed 5 ms early on the 2 kHz scale and both the
    e-CzasPL clock and the DCF77 second looked 5 ms later against GPS than they are (first NEO-7P run
    1 Oct: e-CzasPL -25.07 ms, DCF77 second mark -7.27 ms vs the expected -1.93). Now anchored to the
    input sample where output n2k begins (block start - dec_pos). Only the PPS report uses the anchor:
    mixers, decoding and the OCXO loop are unchanged.
    [main.c]
2026-10-01 DCF77 phase code: PTB sequence starts with chip 0 = 0 - every phase-code time was one chip (1.548 ms) late
    PTB's 512-chip sequence begins 00000100011000010011100101010110000... (Wikipedia DCF77); our 9-stage
    register yields it from chip 1 on, so our chip 0 was correlated with PTB's chip 1 and the second came
    out 120 carrier cycles = 1.548 ms late. Found 1 Oct 2026 with a GPS PPS (NEO-7P): DCF77 phase-code
    second 8.745 ms after UTC vs 1.93 ms expected = 5.00 ms (PPS anchor bug, a03170e) + 1.55 ms (this)
    + ~0.27 ms. Corrected sequence: 256 ones / 256 zeros (PTB: both phase shifts equally distributed).
    Also explains TDF - DCF77 = -1.8 ms at the transmitters (now ~-0.26 ms).
    Same fix in the too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
2026-10-01 Timing review fixes: e-CzasPL second = ramp start, sample-count read, sub-sample DCF77 mark, bias-free fit tools
    From an independent review of the timing chain (1 Oct 2026); the user chose the ramp-start definition.
    - ecz.h: ECZ_TEMPLATE_LAG_US 7400 -> 0. The core models each bit change as a 16 ms ramp STARTING at the
    bit edge and the transmitted signal is such a ramp (16.6 ms, linear), so the core reports the ramp
    start = GUM's 'transmission starts at the beginning of the second'. The 7400 of 75340d9 had a wrong
    explanation (tracker switching ~5 ms) and put the second ~0.5 ms before the ramp middle.
    - main.c pl_calibrate: read the DMA sample count in the same interrupt-free window as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
    [main.c]
2026-10-01 e-CzasPL ramp is 18.6 ms (GUM: 19 ms), not 16.6: tools use it; firmware second corrected by -1380 us (built, NOT flashed)
    The ramp length fitted on the IC-7610 (1 Oct, 60 frames, both edges of the '0' of 1-0-1): 18.58 ms,
    rms residual 0.009 (19.0 ms: 0.011, 16.6 ms: 0.031). GUM gave 19 ms to J. Sadowski (Metrol. Meas.
    Syst. 32(4) 2025, DOI 10.24425/mms.2025.155800); it is not in the specification. A too short ramp model
    puts the ramp start late.
    - tools/timing_models.py: E_RAMP 16.6 -> 18.6 ms (tdf_vs_eczas_timing, eczas_transition_shape,
    nucleo_timing_check use it).
    - nucleo_timing_check.py: the timing_models alias 'tm' was shadowed by the TIMEMAP list (broken since
    6bd5276) - renamed T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
2026-10-01 OCXO: phase lock to the GPS PPS (classic GPSDO, PI on the PPS phase), DCF77 / e-CzasPL as fallbacks; per-minute REFS line; carriers_vs_gps.py (built, NOT flashed)
    The user wants the OCXO locked to GPS and the DCF77 and e-CzasPL carriers measured against it.
    - main.c: each GPS pulse's phase within the OCXO second (timer capture), unwrapped, glitches (> 10 us
    step) dropped, averaged per minute; >= 50 pulses -> efc_minute3; new line every minute
    'REFS GPS g ppb, phase p ns (n pulses) | DCF77 d ppb | e-CzasPL e ppb' (OCXO error against each
    reference, 0.001 ppb). EFC_USE_GPS 0 restores the old behaviour.
    - efc.c/h: EFC_SRC_GPS, efc_minute3: the station bookkeeping (noise, learned e-CzasPL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
    [main.c]
2026-10-01 GPS plausibility gate (phase jump / disagreement with DCF77 and e-CzasPL), station fallback after 1 h of suspension; gps_monitor.py (built, NOT flashed)
    User: 'make sure that GPS PPS is used only when GPS is locked and monitor that e-CzasPL and DCF are always
    measured against PPS'.
    - Receiver side (already): the NEO-7P sends a time pulse only while locked (CFG-TP5 pulse length 0 when
    unlocked).
    - tools/gps_monitor.py (container gps-monitor): the receiver's own NAV-STATUS / NAV-TIMEUTC / TIM-TP / GGA
    every second -> /data/claude/gps/gps_YYYYMMDD.csv, status.txt, alerts.log (lock lost/regained, tAcc,
    satellites); reopens the by-id device.
    - efc.c efc_minute3: GPS checked from its RAW pha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
2026-10-02 Review 3 fixes: per-pulse GPS jump gate, unbiased DCF77 phase-code peak, true rate in the first block, implausible e-CzasPL decodes ignored (built, NOT flashed)
    - main.c / efc.c: GPS phase jump detected pulse by pulse (step > 300 ns from the running mean of the
    per-second steps, or a > 10 us glitch after a settled run) -> efc.gjump_ext -> suspended 10 min. The
    minute-mean check missed a 550 ns step landing mid-minute (review 3). efcgpssim mode 4 step at 0/15/30/
    45/59 s into the minute: all detected, time error <= 41 ns (was: 30 s undetected, 684 ns). Normal /
    cold start / outage: 0 suspended minutes. Real PPS since 1 Oct 18:01 (49017 pulses): 0 flagged, max
    deviation 54 ns.
    - dcf.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
    [main.c]
2026-10-02 README timing + ecz.h comment: GUM's statement (2 Oct): carrier and frame start from an OCXO for now (rubidium soon), receiver time instant = start of the 16-bit sync; GPS night results, TDF via GPS,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
2026-10-02 dashboard: wording - e-CzasPL carrier and frame start temporarily from an OCXO until the rubidium replacement
2026-10-02 dashboard: static page early_frames.html (bilingual e-CzasPL early-frame observation report, 2 Oct 2026) linked from the main page
2026-10-08 DCF77: recover from fades - amplitude gate, restart on a new line, no permanent 0 Hz rejection
    7 Oct 2026 a DCF77 fade (12:30-13:50 UTC) left the receiver stuck in "searching" until a reset
    (8 Oct 17:31). The running sums were divided by the carrier amplitude, which goes to ~0 in a
    fade: minute sigma 292 -> 3678, the minute marker on a wrong second (no minute decoded from
    07:44), then the loop slid onto a spur at -1.6 Hz, whose frequency shifted the fold 12.4 ms
    per block. Back on 0 Hz the polluted fold showed no second marks for an hour, so 0 Hz was
    rejected - for ever (the exclusion list was only cleared by a reboot).
    - dcf.c: samples count only while the amplitude is above DCF_AMP_MIN (0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
    [main.c]
2026-10-08 DCF77: review fixes to the fade recovery (53dd701)
    - amp_n saturates at 40000 (it wrapped after 24.9 days: division by 0, amp = NaN, DCF77 stuck);
    the gate is written so a NaN counts as not usable; good_run saturates
    - amp_ref is a double (in float the 1/7.2e6 steps were rounded away: it never fell)
    - the fold and the phase-code fold are weighted by the amplitude (maximum-ratio) instead of divided
    by it: a weak stretch or a block with a few usable seconds counts for little, also after a
    restart in a fade; the last block's usable fraction is kept ("locked ..., faded" in the report)
    - dcf_restart also drops a block being evaluated (stage 0)
    - OCXO build: the DCF77 search covers 0 +- 0.2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
    [main.c]
2026-10-08 DCF77 time code: expected frame in the zone of its own minute (DST change)
    The expected-frame confirmation encoded every minute in the zone of the first confirmed minute
    (ref_cest was never updated): after a DST change every PREDICTED minute was printed 1 h off with
    the wrong CET/CEST and fitted 24 points worse. The zone now comes from the EU rule (summer time
    from the last Sunday of March to the last Sunday of October, 01:00 UTC) for each minute, so the
    change minute itself is right too; ref_cest is gone.
    Test (host): 25 Oct 2026 02:59 CEST -> 02:00 CET predicted correctly (was "03:00 CEST"), rule
    right at the change minutes 2026-2028, every minute of 2026-2027 encodes and checks back.
    Co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
2026-10-08 OCXO: calibration works with the GPS, FAIL is retried, jump prediction aligned
    - WAIT / CAL with the GPS steering got the frequency 0 every minute (the phase offset is re-taken each
    minute outside LOCK): any recalibration with the GPS (slope 0 at start, or 5 outliers in LOCK, e.g.
    a sustained GPS error or an OCXO step) ended in FAIL - for good. They now get the raw GPS frequency
    of the minute (no minute without a previous phase: source NONE).
    - an outlier minute in GPS LOCK keeps the measured phase, so the next minute is not an outlier again
    - FAIL is left for WAIT (a new calibration) after EFC_FAIL_RETRY (60) minutes
    - GPS jump check: a code change shows half in the minute's mean phas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
2026-10-08 NUCLEO time base: survive missed captures, overruns and debugger halts
    - a missed reference capture (interrupts blocked > 250 us; overcapture flag or a 16-bit interval
    > 1 % off) broke the true-time mapping until a reset (8 Oct 2026 18:00:59: a flash read halted the
    core; e-CzasPL / DCF77 seconds stepped 13 ms, carrier lost). The ISR counts it, main recalibrates
    the mapping and says so.
    - the ISR no longer writes 0 to the capture flags (that dropped a capture arriving during the
    handler; reading CCRx clears them), only the overcapture flags
    - GPS PPS and a pending reference capture are booked in the order they happened (with a late
    interrupt the pulse was taken from the older captu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
    [main.c]
2026-10-08 Sample numbers past 2^32 (24.9 days of uptime)
    TIMEMAP printed n2k as 32 bits and the dump packets carry 32 bits: both wrapped after 24.9 days
    and offline alignment (idx.csv, TIMEMAP, dcf_track, nucleo_timing_check) broke. TIMEMAP now
    prints the full 64-bit number (u64s: this printf has no %llu); the packet format stays, the
    logger unwraps its 32-bit number per stream (wrap: last > 0xF0000000 and new < 0x10000000; any
    other step back = a reboot, starts again) and writes the 64-bit number to idx.csv.
    [main.c]
2026-10-08 DCF77: second count kept when the mark crosses 0/1999; phase-code time reset with its fold
    - the second count is (n - mark) / 2000: a mark moving a few samples across 0/1999 (mark noise, or
    the drift shift) changed it by one, so every second was one slot off - dips, minute marker,
    time-code bits (all minutes failed) - for ~50 min, on ~0.2 % of boots for the whole run (LSE
    build: about daily by drift). move_mark() rotates the per-second dips and the minute with it.
    - the phase-code fold counts its seconds from the mark too (from pm_ref it was one off when the two
    sat on either side of 0/1999)
    - when the phase-code fold restarts (minute or mark moved) its time and sigma are cleared as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
2026-10-08 GPS PPS processed in the block it is converted in
    The pulse was converted every block (5 ms) but processed once per second of the 2 kHz scale, from a
    one-slot mailbox: when the pulse fell 0-5 ms after that second's boundary (fixed at boot, ~0.5 % of
    boots), the next pulse overwrote it first - 20-30 % of the pulses lost, fewer than 50 per minute, so
    the GPS stopped steering or the source toggled every minute. Each pulse is now processed right after
    its conversion.
    [main.c]
2026-10-08 NUCLEO: watchdog, fault handlers that reset, reset cause at start
    Running 24/7, a hang or a fault stopped the receiver until someone pressed reset (HardFault spun,
    the other faults fell into the startup's default loop, no watchdog; a DMA transfer error leaves the
    ADC stream off).
    - IWDG1, 4 s, fed once per processed block (every 5 ms): a hang or a stopped DMA resets; frozen while
    a debugger halts the core
    - HardFault / MemManage / BusFault / UsageFault / NMI note the fault and the stacked PC in a .noinit
    record and reset
    - at the start: "reset: watchdog / software / power-on / brown-out / reset pin ...", and
    "reset after a <fault> at PC 0x..." when a fault was recorded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
    [main.c]
2026-10-08 NUCLEO clocks within spec; clock setup errors reported; no-reference fallback mixes both stations
    - VOS0 instead of VOS1: SYSCLK from HSI is ~402.5 MHz (+0.63 %), above VOS1's 400 MHz, and AXI
    ~201 MHz with 2 flash wait states needs VOS0 (RM0468)
    - PLL2 for the ADC: VCO 288 MHz / 8 = 36 MHz (it ran at 144 MHz, below the medium VCO range);
    same ADC clock and trigger ratio
    - the HAL results of the clock setup are checked; a failure shows in the "reset:" line at start
    - without a reference: FS_GUESS for HSI (~1006300 Hz; the old ST-LINK MCO value put e-CzasPL ~730 Hz
    off, outside its search), and set_mix() sets the DCF77 mixer too (it stayed at 0 Hz)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
    [main.c]
2026-10-08 OCXO loop: learned GPS offsets bounded, anti-windup, EFC code kept over a reset
    - the stations' frequency offsets learned against GPS (plausibility check) stay within +-3 ppb
    (EFC_GPS_OFS_MAX): a GPS wrong from the start, or ramping away slowly, was learned into them and
    never caught. host/efcgpssim mode 7 (GPS frequency +0.4 ppb per 10 min from mid-run): was followed
    to 2.5 ms off, never suspended; now suspended (disagreement) after ~5 h, 0.2 ms max
    - PI step shared by the GPS and station branches; no integration while the target is against a rail
    - main.c: the locked EFC code is kept in .noinit and used at the next start after a reset (watchdog,
    fault, st-flash --reset); a power cy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
    [main.c]
2026-10-08 e-CzasPL tracker: lvl0 learned only while the loop is quiet; no spur lock
    - the '0' level (decision-directed) was learned up to 15 deg of loop noise; above ~10 deg the
    decisions are biased and it ran to the -60 deg clamp (rx.log: -52..-54 deg at 12-18 deg noise,
    -34 deg true), which moved the decision threshold and added loop noise. Learned now below 8 deg;
    coh_level_hint (decoded frames) corrects it otherwise. Clamp -20..-60 deg, as the hint.
    Reviewer's lvl0sim (true -35 / -45 deg, 900 s): at 32-34 dB-Hz loop noise 16.2 -> 13.8 and
    14.9 -> 12.3 deg (lvl0 no longer at the clamp); >= 44 dB-Hz unchanged.
    (A symmetric window around lvl0 was tried: it ran to the other clamp, -20 deg.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
    [main.c]
2026-10-08 e-CzasPL reporting: no-signal frames, candidate overruns, time in holdover
    - a frame whose levels did not separate (FR_NO_SIGNAL) printed "snr 0 dB" (fi not filled): now
    "(no signal)"
    - ez.cand_overrun (a candidate came before the previous one was handled) was counted but never
    shown: STATUS " CANDOVR"
    - STATUS showed the time as valid after any time without frames: "(holdover > 24 h)" when tk_valid
    says the last good frame is more than HOLDOVER_VALID_S old
2026-10-08 STATUS: buffer as long as put_line carries, flags appended bounded
    The holdover note and CANDOVR made the worst-case STATUS line ~430 bytes for a 420-byte buffer
    filled by strcat; main's line buffer is 456 bytes (put_line's 480 minus its prefix) and the flags
    are appended with strncat.
2026-10-08 DCF77: expected-frame grid tolerance 1 ppm on the OCXO; pm_lag_ms described right
    on_grid allowed +-0.5 s + 20 ppm of the time since the reference minute (sized for the LSE crystal):
    with the OCXO as the sample clock that grew to +-30 s after 17 days without a decode. OCXO build
    1 ppm (DCFB_GRID_PPM), LSE build 20 ppm as before. dcf.h: pm_lag_ms is the second's start from the
    phase code relative to the mark (the comment said +200 ms).
2026-10-08 REFS / OCXO lines: GPS values while suspended, no source in FAIL
    REFS printed the loop's GPS frequency and phase, which stop updating while the GPS is suspended
    ("GPS 0.000 ppb" for the whole suspension): the frequency is now the raw minute value, the loop
    phase is "-" while suspended. The OCXO line said "source GPS" in FAIL: none.
    [main.c]
2026-10-08 Dump packets with a CRC; the logger drops broken packets and binary garbage
    ~80 dump packets a day lost bytes on the ST-LINK serial link (not in the firmware: the TX ring is
    all-or-nothing and never overflows). The logger then read 1606 bytes into the next packet and
    stored a packet with a right index and wrong data (44 in the recent .c64 files, values up to 1e32),
    and wrote the rest as binary "text" lines into rx.log.
    - firmware: each 2 kHz packet ends with a CRC-16/CCITT-FALSE of index + samples (1608 bytes)
    - logger: a packet must pass the CRC, otherwise it resyncs on the next byte; a valid packet clears a
    pending partial line (packets and lines are sent whole, so that is a broken packe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
    [main.c]
2026-10-08 TX ring: dump packets leave 2 KB for text lines
    All or nothing for every write: with the link saturated, FRAME / CLOCK / STATUS lines were dropped
    as readily as the sample dumps. A dump packet is now written only if 2 KB stay free after it.
2026-10-08 NUCLEO: eCzas core's frame-pair tolerance 10 ppm (TK_PAIR_PPM)
    The 2 kHz scale is true time (OCXO / LSE), so 20 ms + 10 ppm instead of the core's 200 ppm for a
    free-running crystal: two of the transmitter's early frames (2.4-2.5 s early, ~16 a day) agreed
    with each other within 140-260 ms tolerances and could synchronise the clock 2.4 s wrong.
    Takes effect with the eczas core that reads TK_PAIR_PPM (submodule update).
2026-10-08 eczas submodule: timekeeper overflow / rate / leap fixes (edc6129)
    The eCzas core now reads TK_PAIR_PPM (set to 10 for the NUCLEO in its Makefile), splits the
    seconds-to-ticks product (no overflow for frames > 40 days off), starts a new rate reference after
    a holdover over 10 days, bounds the rate to 200 ppm and measures it again after a leap second.
    Also brings the eCzas repo's other changes since 0b4dfbe (no core files among them).
2026-10-08 carriers_vs_gps: skip minutes without a GPS value
    REFS prints "GPS - ppb" in a minute with fewer than 50 pulses; float("-") stopped the script, and
    the container kept the report of 8 Oct 07:14 while saying "report updated".
2026-10-08 UART: TX FIFO refilled at half empty
    USART3 interrupted for every byte (TXFNF): ~92k interrupts/s at 921600 baud, ~1.5 % CPU. The
    16-byte TX FIFO is now enabled and refilled at the half-empty threshold (TXFTIE, as the HAL's
    FIFO mode does): one interrupt per ~8 bytes. Hardware test pending.
2026-10-08 e-CzasPL: a frame without a readable marker can be confirmed by the expected time frame
    FR_NOT_TIME (marker > 2 bits off) was dropped at once; at low C/N0 that is also a damaged time frame.
    With the clock synchronised, it is now compared with the expected time frame like an uncorrectable
    one (frame_confirm, CONFIRM_MIN_Q10, accepted only within the clock's 100 ms); otherwise still dropped
    and not counted as heard. FRAME line "(no marker)".
    Bench: host/cohsim -T (new) on 6 h of the NUCLEO's e-CzasPL dump (6 Oct 12-18 UTC, gaps zero-filled,
    truth from the host time), noise added: none / 5 / 0 / -3 dB -> 0 / 5 / 44 / 0 more confirmed frames
    (+14 % at 0 dB, 12 of them in the :03 slot that alway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
    [main.c]
2026-10-08 DCF77: the leap-second minute (61 s) keeps the decoder in step
    With a leap second the minute has 61 seconds (second 59 a 0 bit, the marker at 60): afterwards the
    second-of-minute count was one off and minutes failed until the minute marker was found again
    (~40-60 min). Now: a confirmed / predicted minute with the announcement bit 19 whose next minute is
    00:00 UTC on the 1st is a leap minute (dcfbits leap_next): its minute-end grid moves by 1 s, and
    dcf_leap_second() skips the extra second's dip and moves the per-second dips and the minute by one at
    the start of second 60.
    Synthetic test (AM + noise, 31 Dec 2026 22:00 - 1 Jan 2027 01:00 UTC, leap second at 23:59:60):
    noise 2: handling off 20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
    [main.c]
2026-10-08 dcf_track: dump packets of the current boot only
    The sample count restarts at every boot, and dump files were matched by sample number: in the first
    hours after a reboot the previous boot's packets with the same numbers were mixed into a block
    (8 Oct 21:00: phase code 10.7 sigma, LSE -13 ppm, TIMEMAP residual 2 ms; 21:20: 23.8 sigma), and a
    file spanning a reboot was skipped whole. A packet is now taken only if its host time fits the
    current boot's time map (+-30 s). 21:20 recomputed: 600 s, phase code 51.4 sigma.
2026-10-08 NUCLEO: cpu % over the whole loop; EFC_INIT 2248; HSE path guarded
    - "cpu %" and "longest block" measured only the block processing; the once-a-second, per-minute and
    10-s work came after the measurement, so a stall there did not show. Measured over the whole
    iteration now.
    - EFC_INIT (power-on start; a reset keeps the last locked code) 2253 -> 2248: the median locked code
    on 8 Oct (202 minutes, 2247.3-2253.0)
    - the HSE path (USE_MCO builds) is set up for the ST-LINK's 8 MHz: #error for another HSE_VALUE (a
    10 MHz OCXO there would have run the PLL1 VCO at 1000 MHz)
    [main.c]
2026-10-08 NUCLEO: first sync needs three agreeing e-CzasPL frames (TK_SYNC_CONFIRMATIONS=2)
    With two, two of the transmitter's early frames could synchronise the clock 2.47 s wrong after a
    start (until normal frames stepped it back). Takes effect with the eczas core cf12b5d.
2026-10-08 e-CzasPL tracker: lvl0 learned up to 15 deg of loop noise again (813096d cost frames); start at -35 deg
    The review change 813096d learned the '0' level only below 8 deg of loop noise, from a simulation of
    the loop noise. Measured on decoded frames it was worse: host/cohsim on 6 h of the NUCLEO's e-CzasPL
    dump with noise added, decoded + confirmed frames 15 deg vs 8 deg: 1615 vs 1026 at 5 dB, 981 vs 352
    at 0 dB (no wrong time in either). And after a start with the level off (22:08 boot) the 8-deg gate
    locked the learning out: the first frame came after 64 s. Back to 15 deg; the level starts at -35 deg
    (measured -34) instead of -45: seven boot starts replayed, 138 frames vs 132 (first sync of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
2026-10-08 e-CzasPL tracker: lvl0 learned only after a decoded frame has set it
    At some starts the one-sided learning window walked lvl0 from its start value to -60 deg within
    20 s, before any frame could decode (22:13 boot: -35 -> -48.6 -> -59.6 deg, first frame after 48 s;
    the replay of its dump through host/cohsim gives the same values). The learning now waits for the
    first coh_level_hint (a decoded frame's measured level). Eight boot starts replayed: 146 frames in
    their first minutes (135 with the code before the review, 141 with c1302ce), first frame of the
    22:13 boot after 21 s, of the 22:08 boot after 16 s; 6 h with noise added unchanged (5 dB 1347 +
    269, 0 dB 414 + 565, no wrong time).
    Co-Auth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
2026-11-08 Docs: status Nov 2026 - GPS-disciplined OCXO and its gate, carriers vs GPS and vs GUM's UTC(PL) monitoring, e-CzasPL second (drift, 21 Oct resync), early frames gone after GUM's 4 Nov change, local i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
    Claude-Session: https://claude.ai/code/session_01DN6rArVB6y7rCDJiVRFQgV
